EllisHobby/Capstone-Project-2022/README.md

# Ortho-matryx Capstone Project

# To install:

# > Open terminal

# > Move to ../Ortho-matryx directory

# > RUN: "sudo bash install.sh"

# > Device will restart and open game application
