EllisHobby/Capstone-Project-2022/gui-app/images/0.png

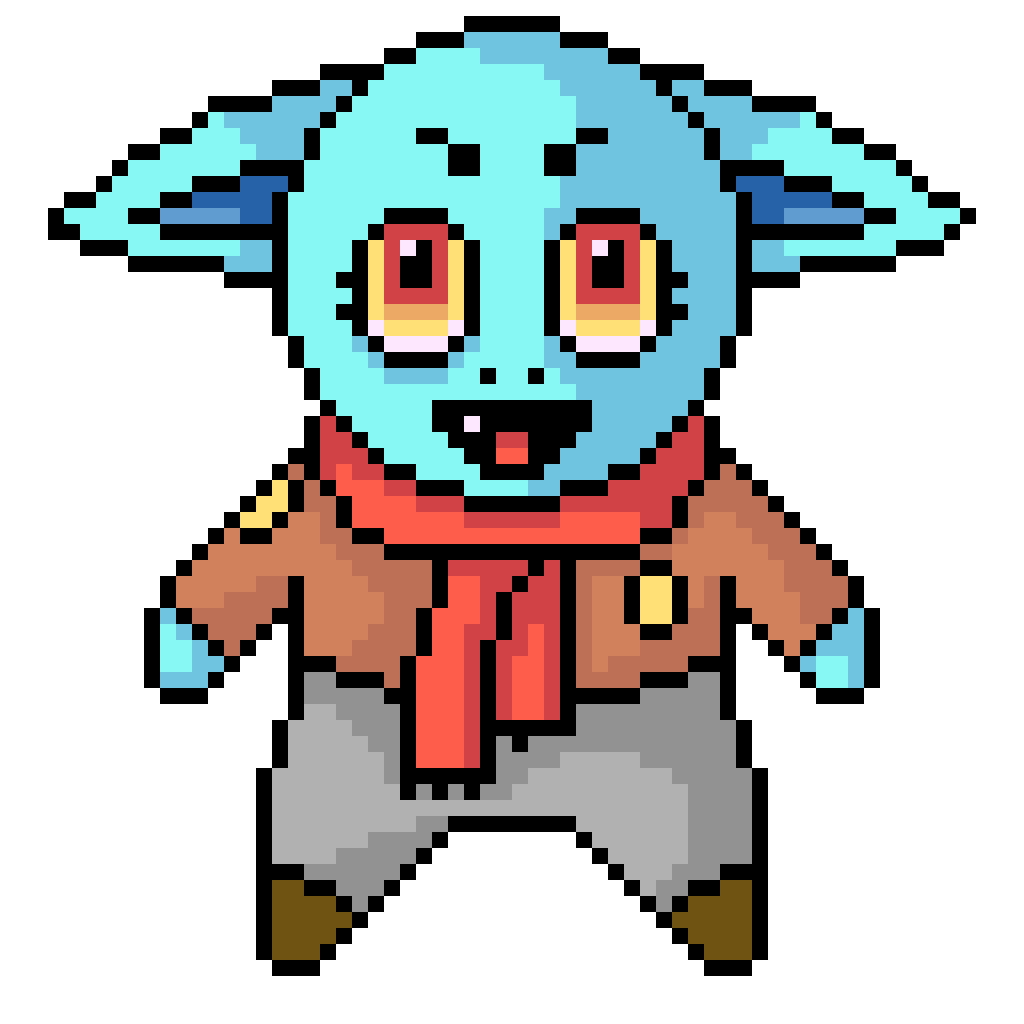
gui-app/images/0.png
