EllisHobby/Capstone-Project-2022/gui-app/images/1.png

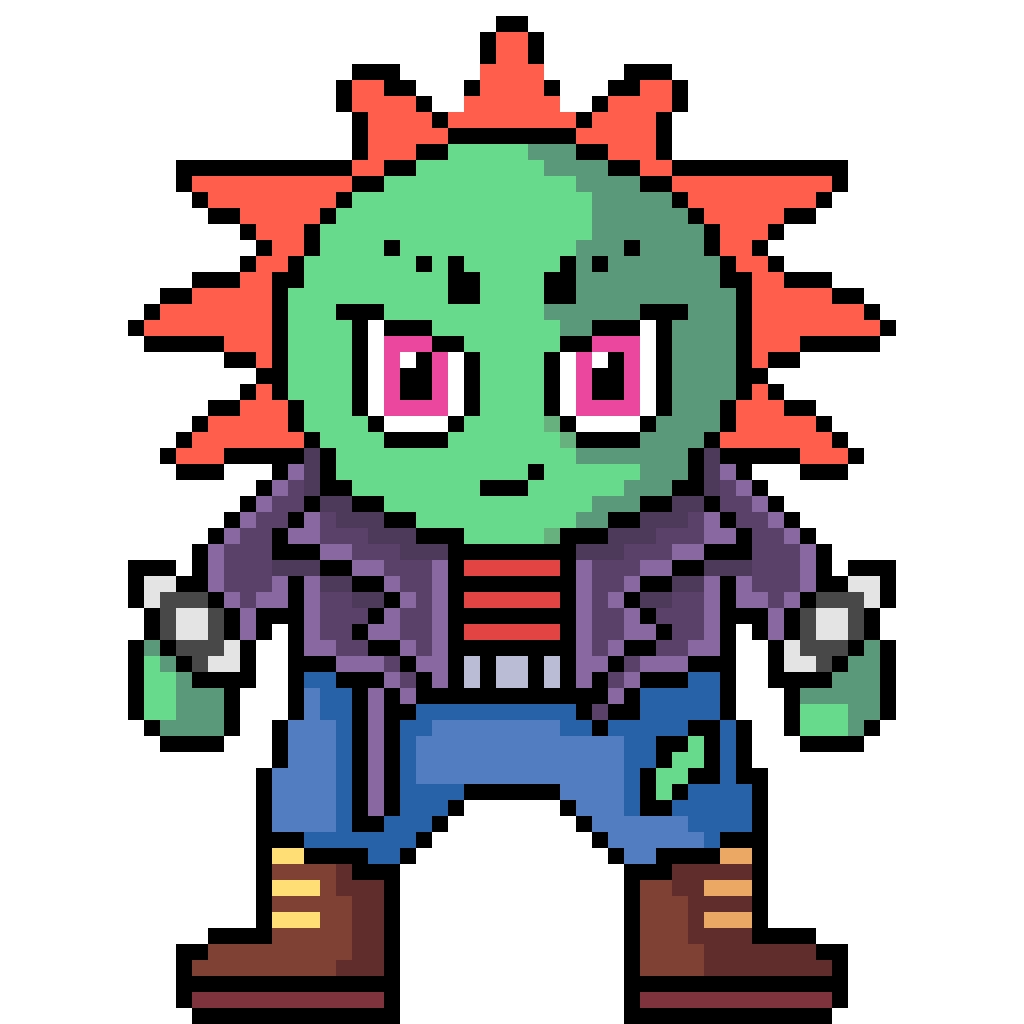
gui-app/images/1.png
