EllisHobby/Capstone-Project-2022/gui-app/images/2.png

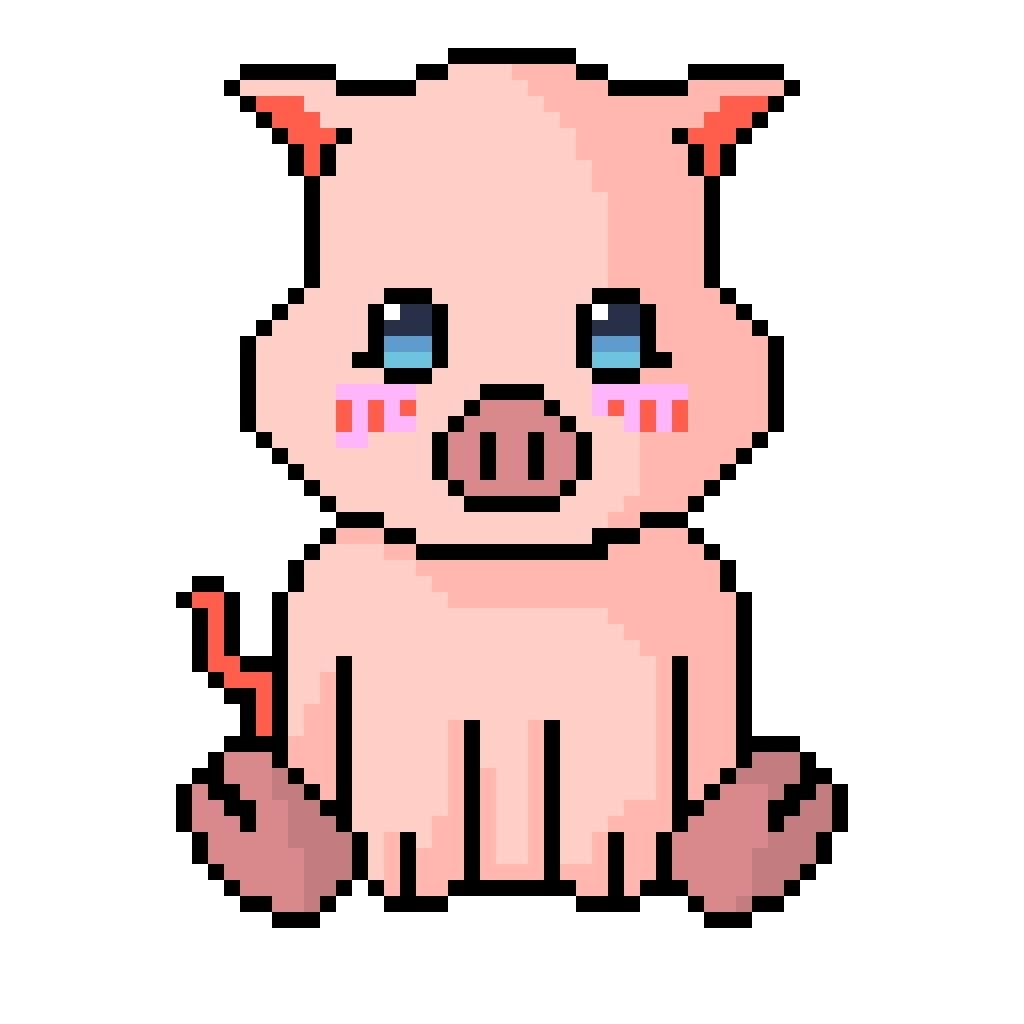
gui-app/images/2.png
