EllisHobby/Capstone-Project-2022/gui-app/images/3.png

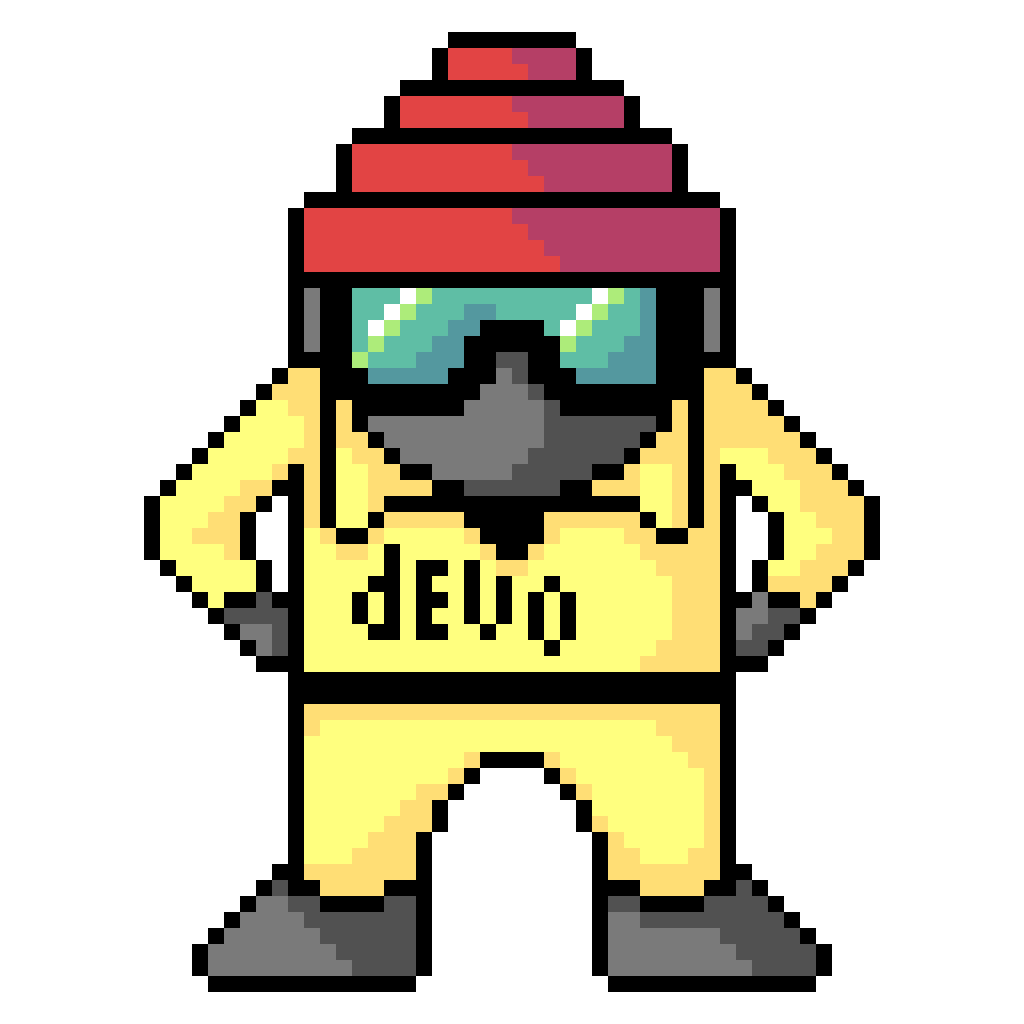
gui-app/images/3.png
