EllisHobby/Capstone-Project-2022/gui-app/images/4.png

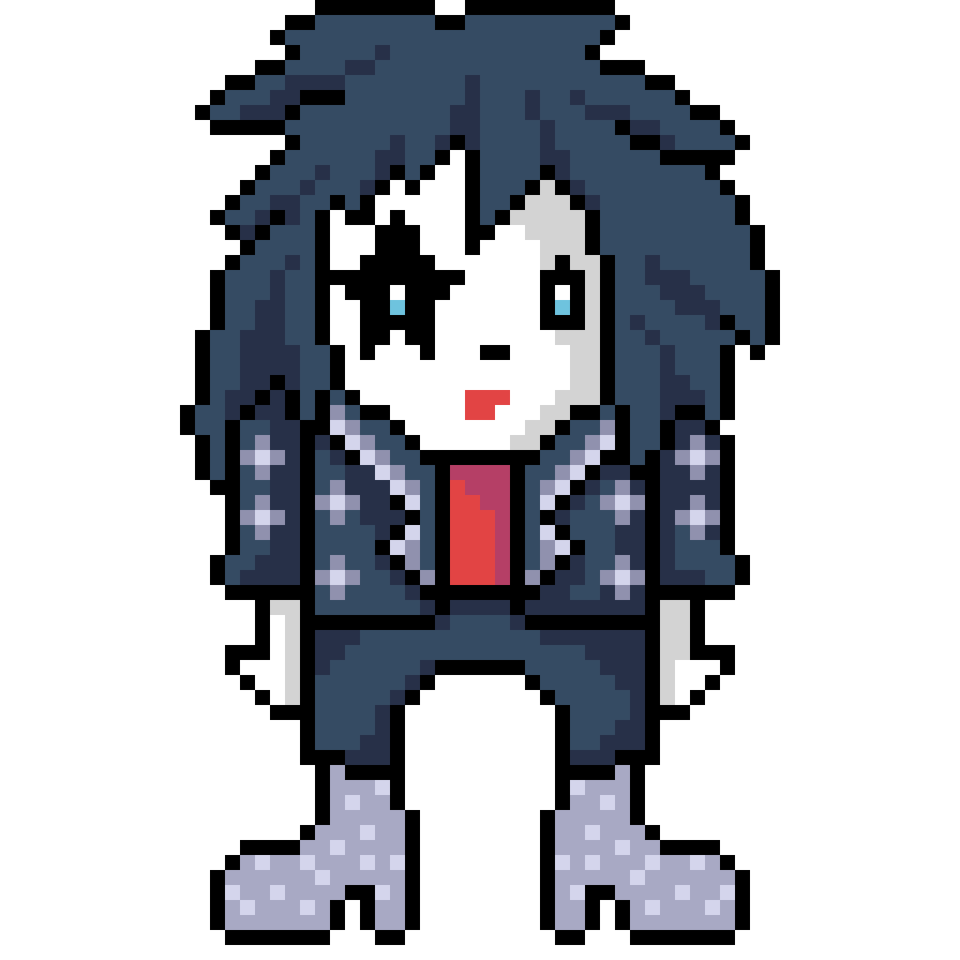
gui-app/images/4.png
