EllisHobby/Capstone-Project-2022/gui-app/images/5.png

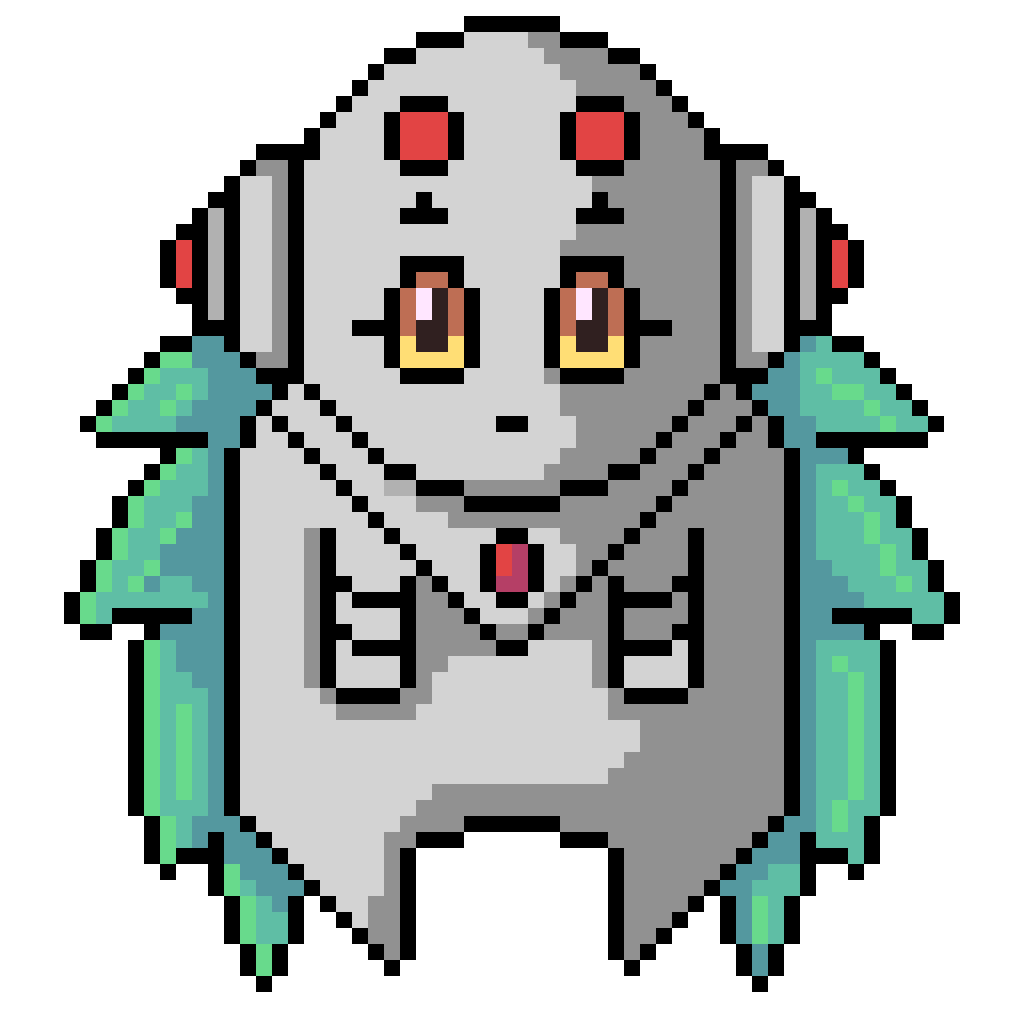
gui-app/images/5.png
