EllisHobby/Capstone-Project-2022/schematics-pcb/V6_Sheet1.png

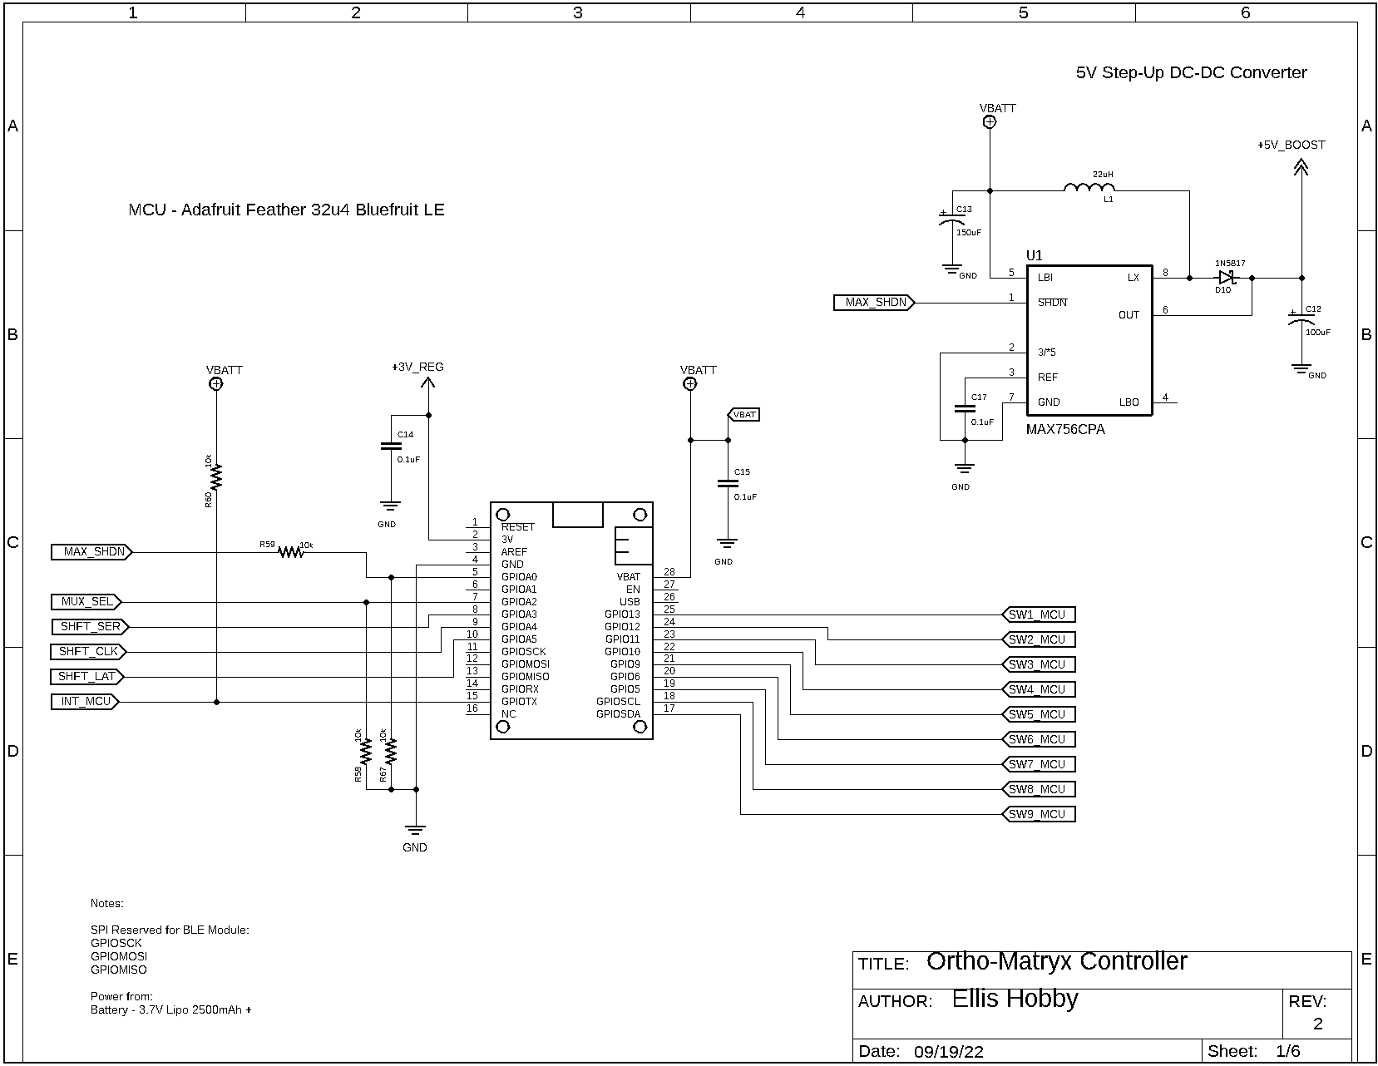
schematics-pcb/V6_Sheet1.png
