EllisHobby/Capstone-Project-2022/schematics-pcb/V6_Sheet6.png

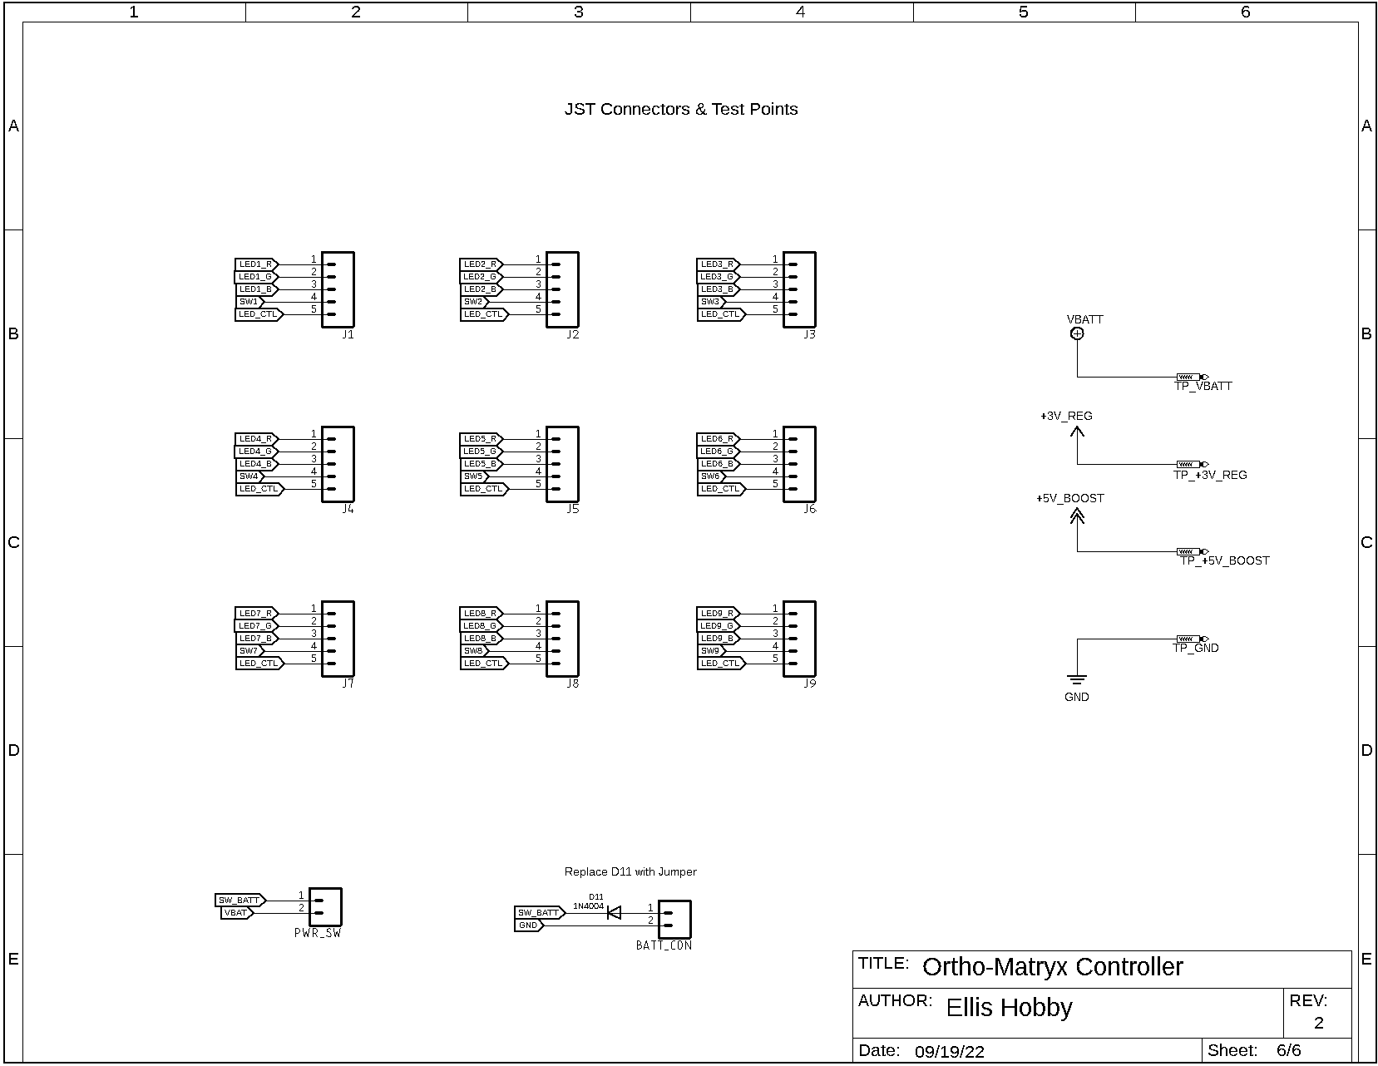
schematics-pcb/V6_Sheet6.png
