EllisHobby/Capstone-Project-2022/schematics-pcb/ControllerV6.brd

## EAGLE design schematics-pcb/ControllerV6.brd (2022-12-15)

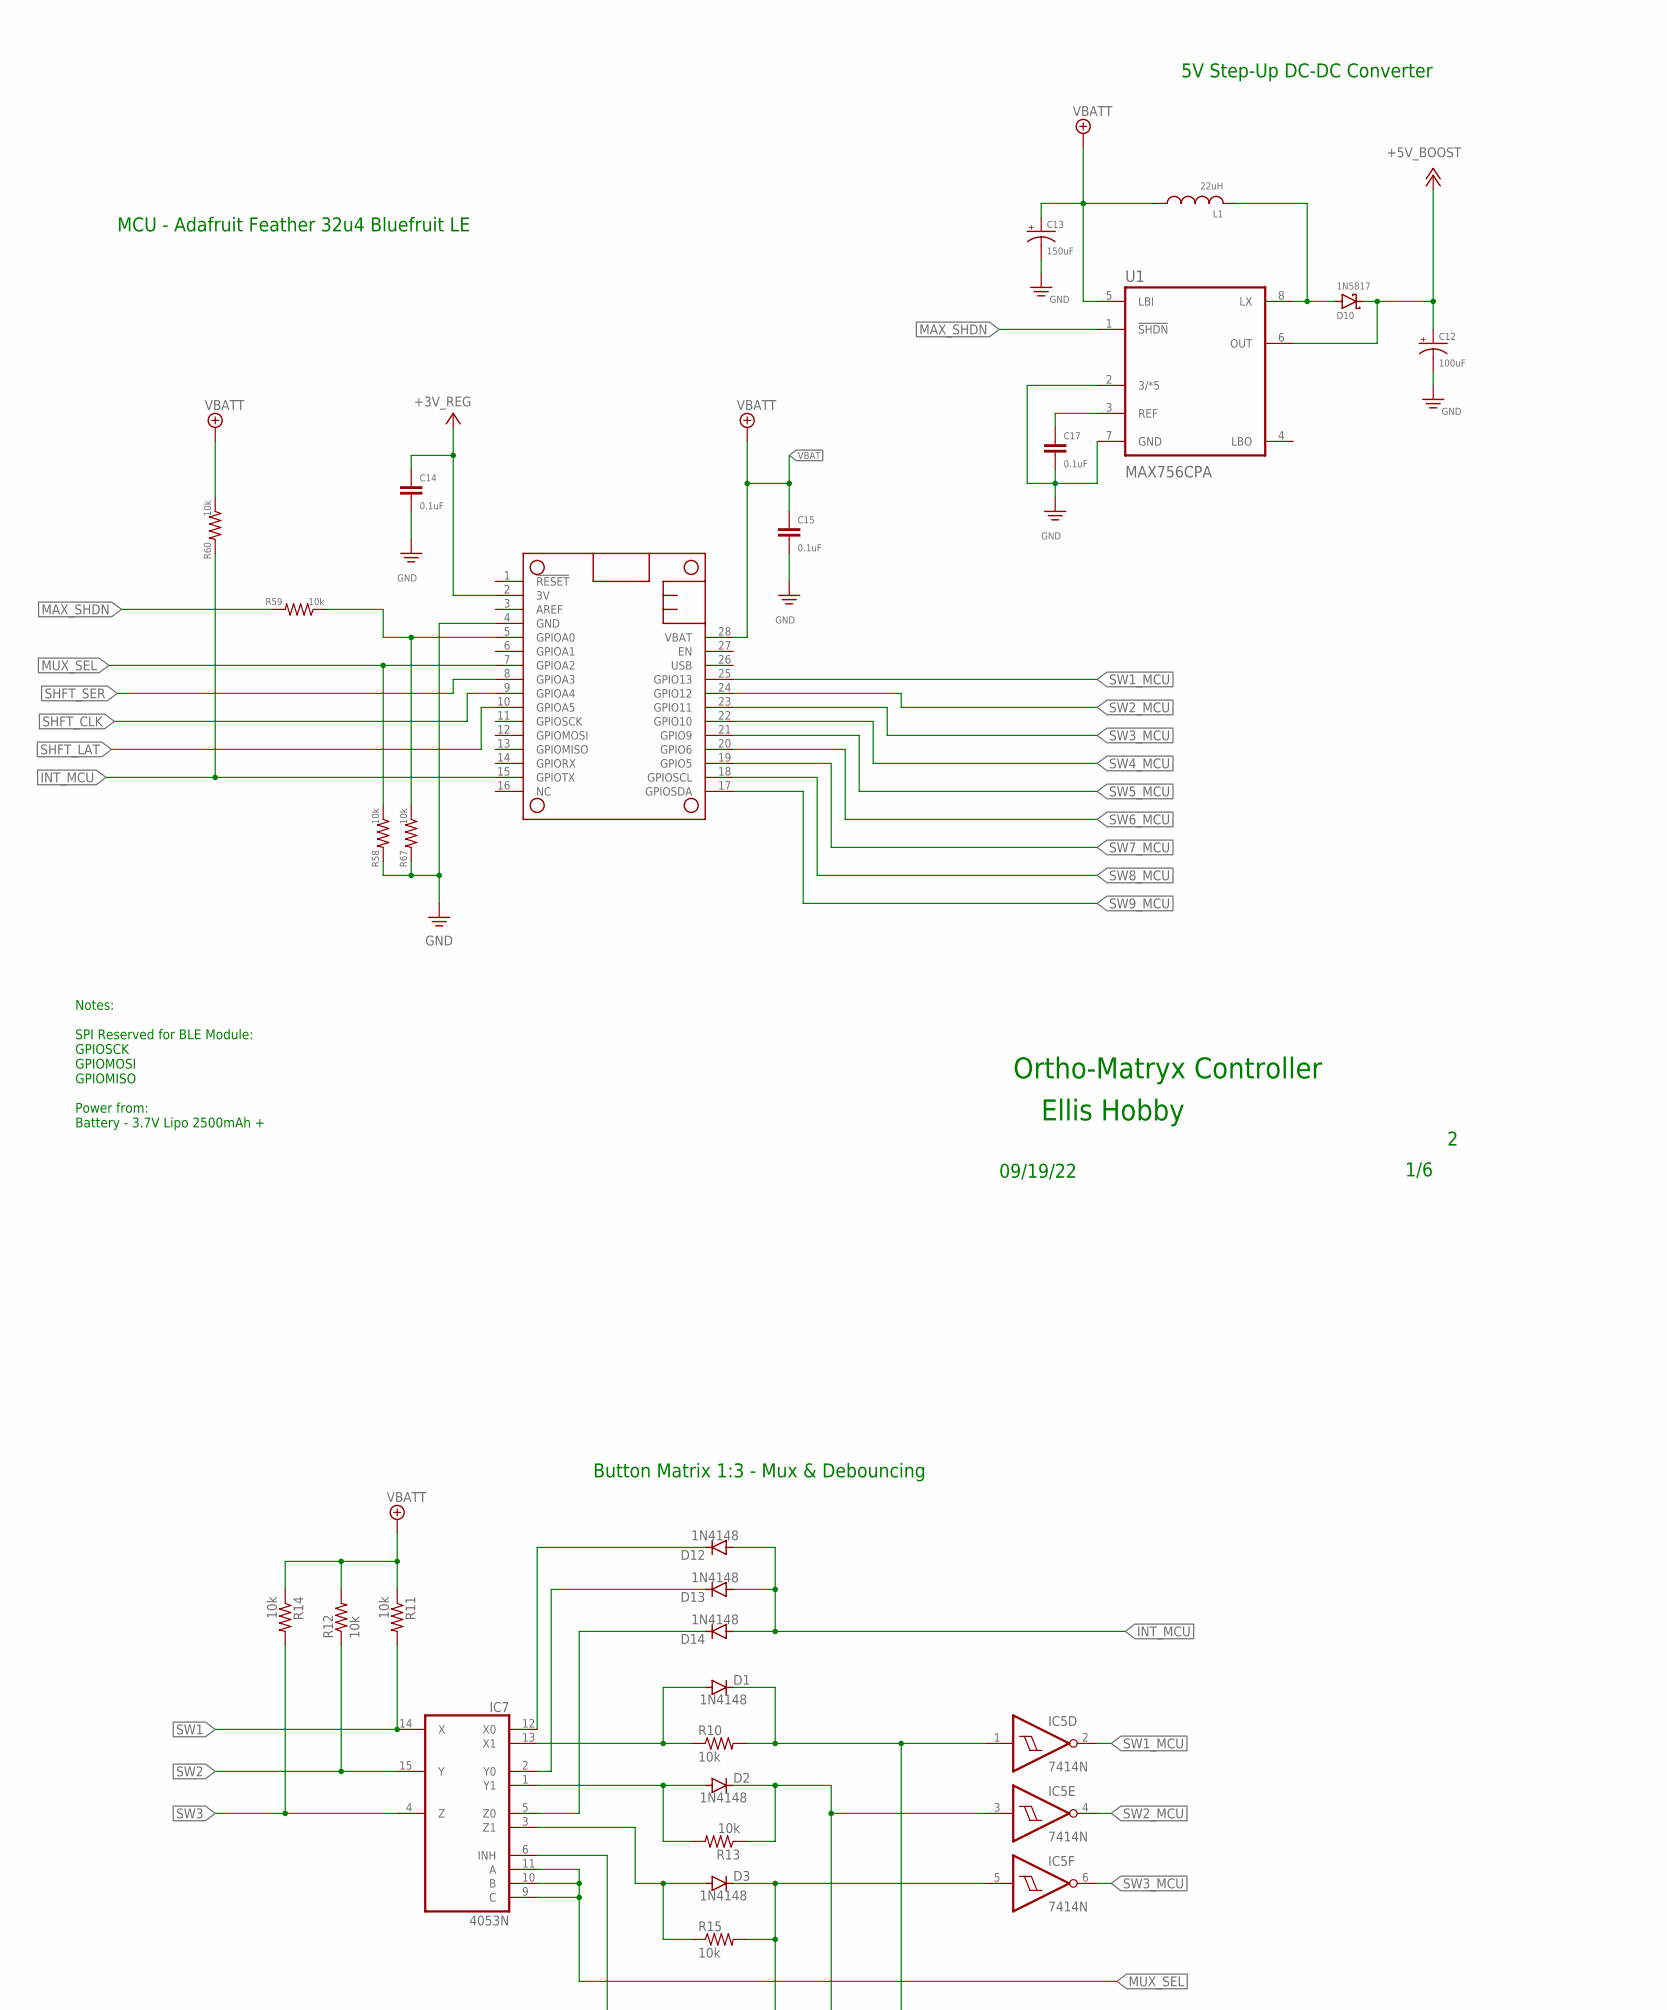
[picture p13: schematic ControllerV6.sch, sheet 1, part in row 1, column 1]

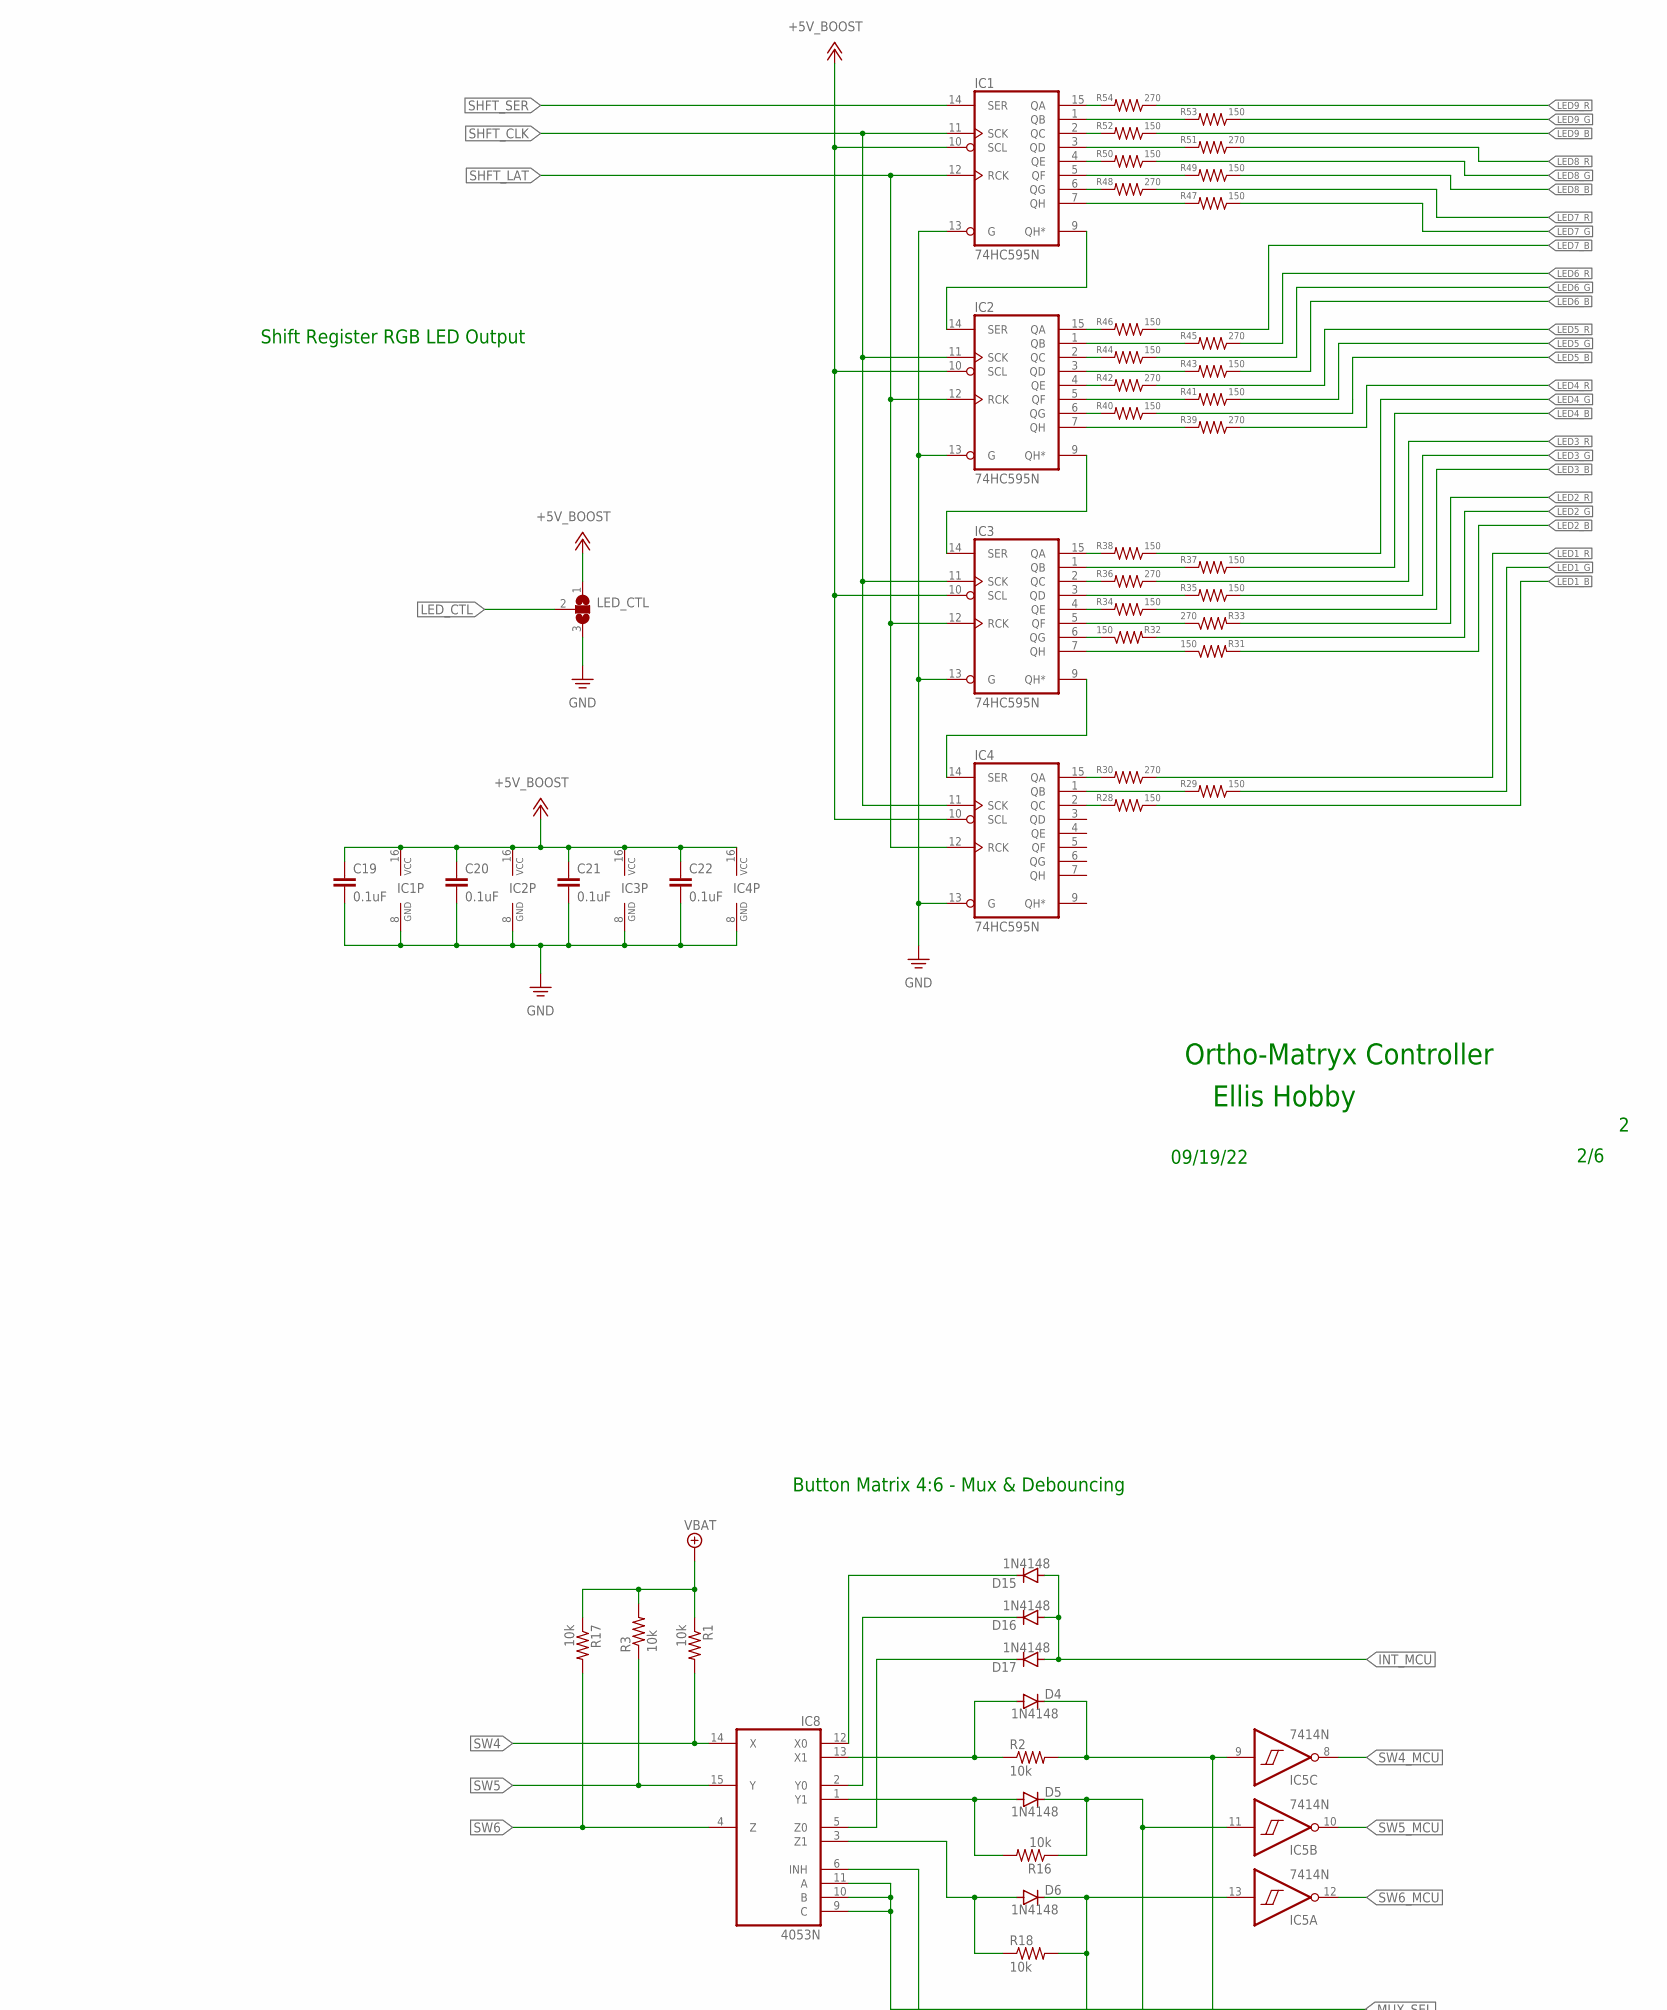
[picture p14: schematic ControllerV6.sch, sheet 1, part in row 1, column 2]

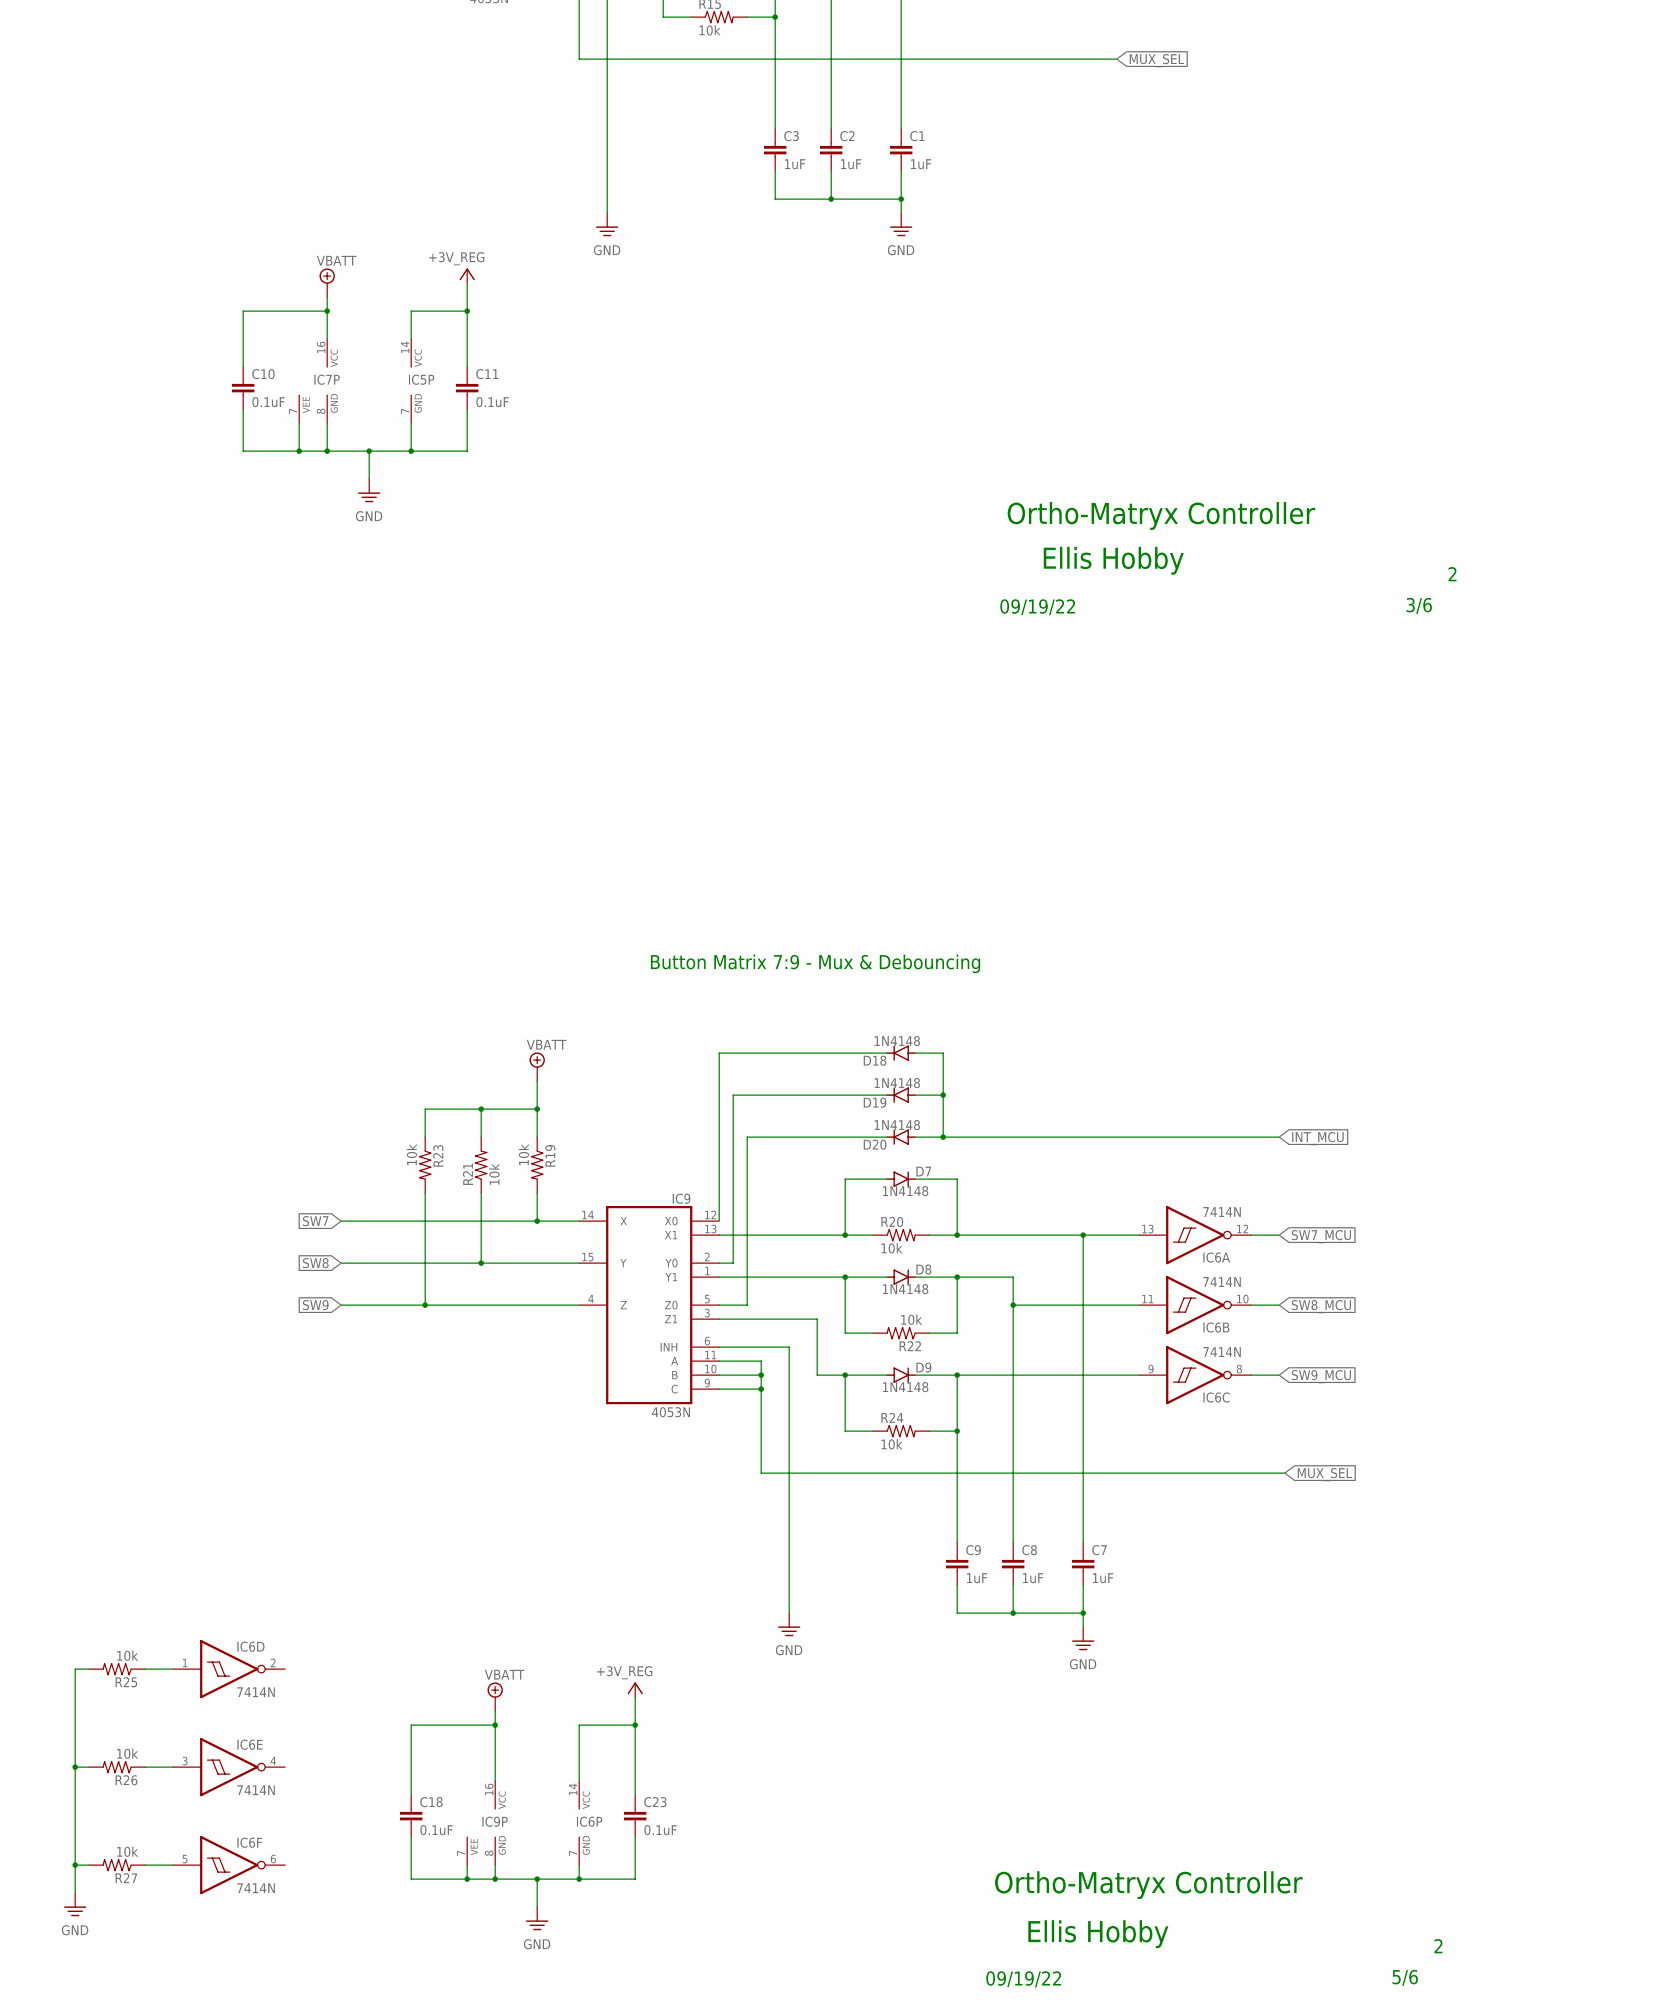
[picture p15: schematic ControllerV6.sch, sheet 1, part in row 2, column 1]

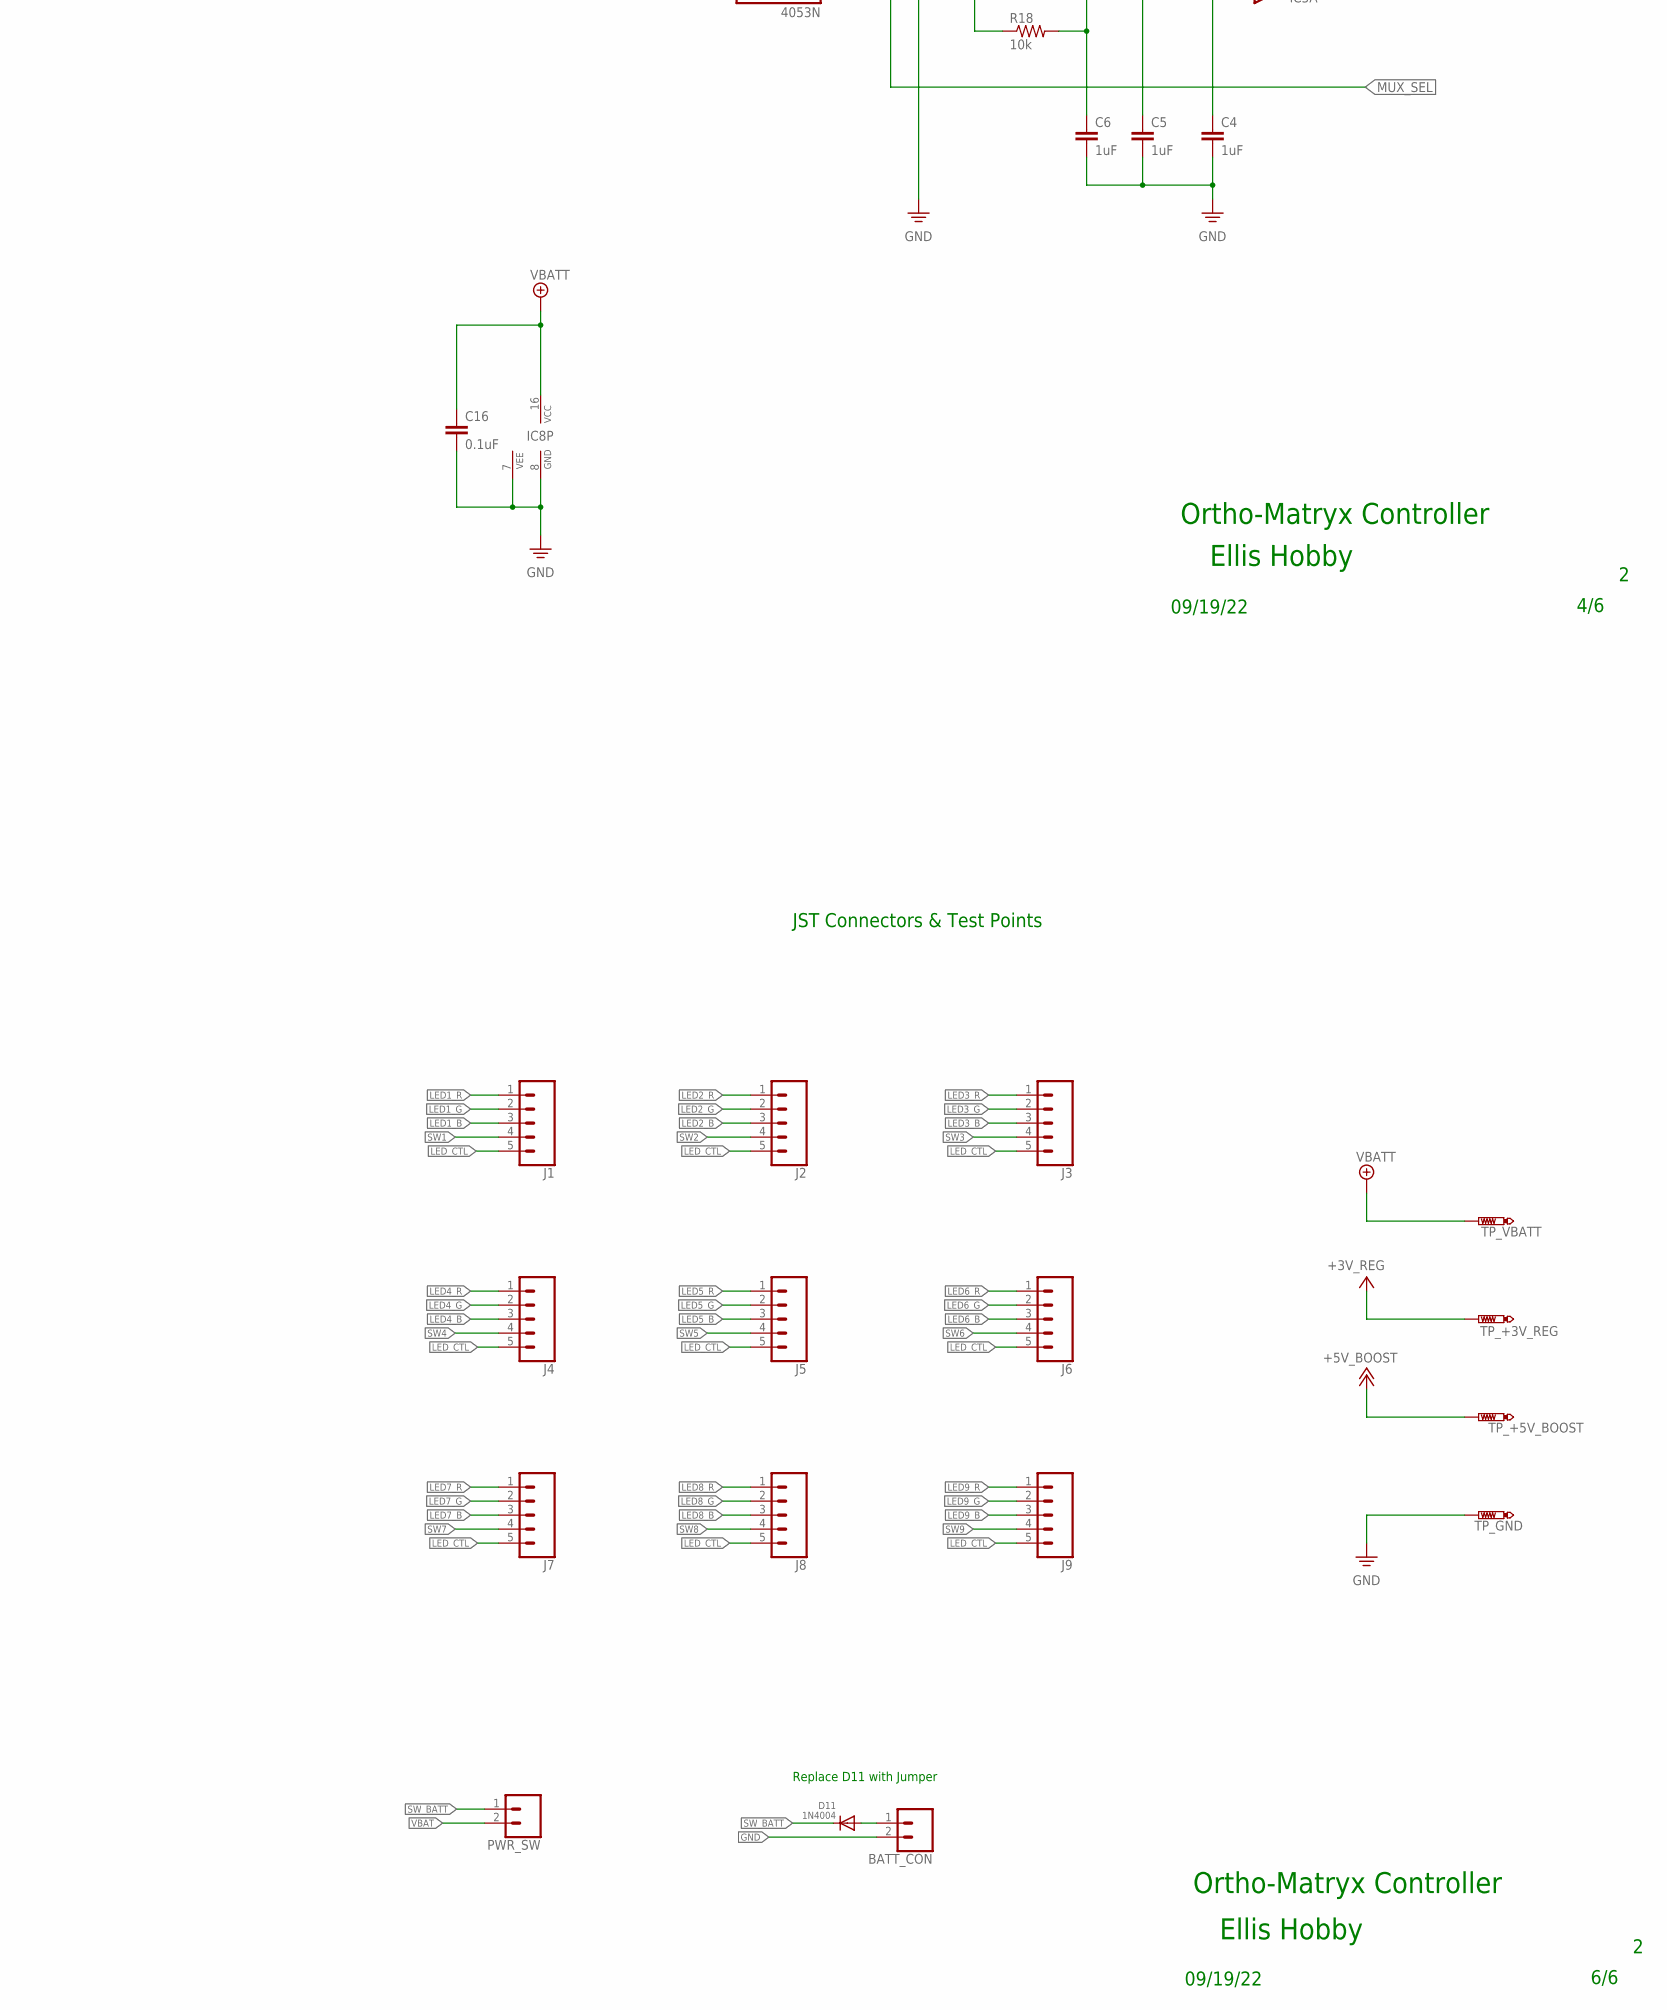
[picture p16: schematic ControllerV6.sch, sheet 1, part in row 2, column 2]

Parts:
BATT_CON: CONN_02POLAR; MOLEX-1X2
C1, C2, C3, C4, C5, C6, C7, C8, C9: 1uF; C025-025X050
C10, C11, C14, C15, C16, C17, C18, C19, C20, C21, C22, C23: 0.1uF; C025-025X050
C12: 100uF; E1,8-4
C13: 150uF; E1,8-4
D1, D2, D3, D4, D5, D6, D7, D8, D9, D12, D13, D14, D15, D16, D17, D18, D19, D20: 1N4148; DO35-7
D10: 1N5817; DO41-7.6
D11: 1N4004; DO41-10
IC1, IC2, IC3, IC4: 74HC595N; DIL16
IC5, IC6: 7414N; DIL14
IC7, IC8, IC9: 4053N; DIL16
J1, J2, J3, J4, J5, J6, J7, J8, J9: CONN_05JST-VERT; JST-5-PTH-VERT
L1: 22uH; 0204/5
LED_CTL: SJ2WW; SJ_2W
MS2: FEATHERWING
PWR_SW: CONN_02POLAR; MOLEX-1X2
R1, R2, R3, R10, R11, R12, R13, R14, R15, R16, R17, R18, R19, R20, R21, R22, R23, R24, R25, R26, R27, R58, R59, R60, R67: 10k; 0204/5
R28, R29, R31, R32, R34, R35, R37, R38, R40, R41, R43, R44, R46, R47, R49, R50, R52, R53: 150; 0204/5
R30, R33, R36, R39, R42, R45, R48, R51, R54: 270; 0204/5
TP_+3V_REG, TP_+5V_BOOST: PTR1PAD1-13Y; P1-13Y
TP_GND: PTR1PAD1-13Y; P1-13Y
TP_VBATT: PTR1PAD1-13Y; P1-13Y
U1: MAX756CPA; DIP794W47P254L991H457Q8

Connections:
+3V_REG: C11.1, C14.1, C23.1, IC5.14 (VCC), IC6.14 (VCC), MS2.2 (3V), TP_+3V_REG.TP
+5V_BOOST: C12.+, C19.1, C20.1, C21.1, C22.1, D10.C, IC1.10 (SCL), IC1.16 (VCC), IC2.10 (SCL), IC2.16 (VCC), IC3.10 (SCL), IC3.16 (VCC), IC4.10 (SCL), IC4.16 (VCC), LED_CTL.1, TP_+5V_BOOST.TP, U1.6 (OUT)
D1: C1.1, D1.C, IC5.1 (I), R10.2
D2: C2.1, D2.C, IC5.3 (I), R13.1
D3: C3.1, D3.C, IC5.5 (I), R15.2
D4: C4.1, D4.C, IC5.9 (I), R2.2
D5: C5.1, D5.C, IC5.11 (I), R16.1
D6: C6.1, D6.C, IC5.13 (I), R18.2
D7: C7.1, D7.C, IC6.13 (I), R20.2
D8: C8.1, D8.C, IC6.11 (I), R22.1
D9: C9.1, D9.C, IC6.9 (I), R24.2
GND: BATT_CON.2, C1.2, C2.2, C3.2, C4.2, C5.2, C6.2, C7.2, C8.2, C9.2, C10.2, C11.2, C12.-, C13.-, C14.2, C15.2, C16.2, C17.2, C18.2, C19.2, C20.2, C21.2, C22.2, C23.2, IC1.8 (GND), IC1.13 (G), IC2.8 (GND), IC2.13 (G), IC3.8 (GND), IC3.13 (G), IC4.8 (GND), IC4.13 (G), IC5.7 (GND), IC6.7 (GND), IC7.6 (INH), IC7.7 (VEE), IC7.8 (GND), IC8.6 (INH), IC8.7 (VEE), IC8.8 (GND), IC9.6 (INH), IC9.7 (VEE), IC9.8 (GND), LED_CTL.3, MS2.4 (GND), R25.2, R26.2, R27.2, R58.2, R67.2, TP_GND.TP, U1.2 (3/*5), U1.7 (GND)
INT_MCU: D12.A, D13.A, D14.A, D15.A, D16.A, D17.A, D18.A, D19.A, D20.A, MS2.15 (GPIOTX), R60.2
LED1_B: J1.3, R28.1
LED1_G: J1.2, R29.1
LED1_R: J1.1, R30.1
LED2_B: J2.3, R31.2
LED2_G: J2.2, R32.2
LED2_R: J2.1, R33.2
LED3_B: J3.3, R34.1
LED3_G: J3.2, R35.1
LED3_R: J3.1, R36.1
LED4_B: J4.3, R37.1
LED4_G: J4.2, R38.1
LED4_R: J4.1, R39.1
LED5_B: J5.3, R40.1
LED5_G: J5.2, R41.1
LED5_R: J5.1, R42.1
LED6_B: J6.3, R43.1
LED6_G: J6.2, R44.1
LED6_R: J6.1, R45.1
LED7_B: J7.3, R46.1
LED7_G: J7.2, R47.1
LED7_R: J7.1, R48.1
LED8_B: J8.3, R49.1
LED8_G: J8.2, R50.1
LED8_R: J8.1, R51.1
LED9_B: J9.3, R52.1
LED9_G: J9.2, R53.1
LED9_R: J9.1, R54.1
LED_CTL: J1.5, J2.5, J3.5, J4.5, J5.5, J6.5, J7.5, J8.5, J9.5, LED_CTL.2
MAX_SHDN: R59.2, U1.1 (!SHDN)
MUX_SEL: IC7.9 (C), IC7.10 (B), IC7.11 (A), IC8.9 (C), IC8.10 (B), IC8.11 (A), IC9.9 (C), IC9.10 (B), IC9.11 (A), MS2.7 (GPIOA2), R58.1
unnamed: IC4.15 (QA), R30.2
unnamed: IC4.1 (QB), R29.2
unnamed: BATT_CON.1, D11.A
unnamed: D1.A, IC7.13 (X1), R10.1
unnamed: C17.1, U1.3 (REF)
unnamed: D13.C, IC7.2 (Y0)
unnamed: D14.C, IC7.5 (Z0)
unnamed: D2.A, IC7.1 (Y1), R13.2
unnamed: D16.C, IC8.2 (Y0)
unnamed: D12.C, IC7.12 (X0)
unnamed: D3.A, IC7.3 (Z1), R15.1
unnamed: D17.C, IC8.5 (Z0)
unnamed: D4.A, IC8.13 (X1), R2.1
unnamed: IC1.9 (QH*), IC2.14 (SER)
unnamed: IC2.9 (QH*), IC3.14 (SER)
unnamed: D5.A, IC8.1 (Y1), R16.2
unnamed: D15.C, IC8.12 (X0)
unnamed: D6.A, IC8.3 (Z1), R18.1
unnamed: D7.A, IC9.13 (X1), R20.1
unnamed: D8.A, IC9.1 (Y1), R22.2
unnamed: D9.A, IC9.3 (Z1), R24.1
unnamed: D18.C, IC9.12 (X0)
unnamed: D19.C, IC9.2 (Y0)
unnamed: D20.C, IC9.5 (Z0)
unnamed: IC4.2 (QC), R28.2
unnamed: IC1.15 (QA), R54.2
unnamed: IC3.9 (QH*), IC4.14 (SER)
unnamed: IC1.1 (QB), R53.2
unnamed: IC1.2 (QC), R52.2
unnamed: IC3.5 (QF), R33.1
unnamed: IC3.6 (QG), R32.1
unnamed: IC3.7 (QH), R31.1
unnamed: MS2.5 (GPIOA0), R59.1, R67.1
unnamed: IC1.3 (QD), R51.2
unnamed: IC1.4 (QE), R50.2
unnamed: IC1.5 (QF), R49.2
unnamed: IC3.4 (QE), R34.2
unnamed: IC3.2 (QC), R36.2
unnamed: IC3.3 (QD), R35.2
unnamed: IC1.6 (QG), R48.2
unnamed: IC1.7 (QH), R47.2
unnamed: IC2.15 (QA), R46.2
unnamed: IC2.1 (QB), R45.2
unnamed: IC2.2 (QC), R44.2
unnamed: IC2.3 (QD), R43.2
unnamed: IC2.4 (QE), R42.2
unnamed: IC2.6 (QG), R40.2
unnamed: IC2.7 (QH), R39.2
unnamed: IC3.15 (QA), R38.2
unnamed: IC3.1 (QB), R37.2
unnamed: IC2.5 (QF), R41.2
unnamed: IC6.1 (I), R25.1
unnamed: IC6.3 (I), R26.1
unnamed: IC6.5 (I), R27.1
unnamed: D10.A, L1.2, U1.8 (LX)
SHFT_CLK: IC1.11 (SCK), IC2.11 (SCK), IC3.11 (SCK), IC4.11 (SCK), MS2.9 (GPIOA4)
SHFT_LAT: IC1.12 (RCK), IC2.12 (RCK), IC3.12 (RCK), IC4.12 (RCK), MS2.10 (GPIOA5)
SHFT_SER: IC1.14 (SER), MS2.8 (GPIOA3)
SW1: IC7.14 (X), J1.4, R11.2
SW1_MCU: IC5.2 (O), MS2.25 (GPIO13)
SW2: IC7.15 (Y), J2.4, R12.1
SW2_MCU: IC5.4 (O), MS2.24 (GPIO12)
SW3: IC7.4 (Z), J3.4, R14.2
SW3_MCU: IC5.6 (O), MS2.23 (GPIO11)
SW4: IC8.14 (X), J4.4, R1.2
SW4_MCU: IC5.8 (O), MS2.22 (GPIO10)
SW5: IC8.15 (Y), J5.4, R3.1
SW5_MCU: IC5.10 (O), MS2.21 (GPIO9)
SW6: IC8.4 (Z), J6.4, R17.2
SW6_MCU: IC5.12 (O), MS2.20 (GPIO6)
SW7: IC9.14 (X), J7.4, R19.2
SW7_MCU: IC6.12 (O), MS2.19 (GPIO5)
SW8: IC9.15 (Y), J8.4, R21.1
SW8_MCU: IC6.10 (O), MS2.18 (GPIOSCL)
SW9: IC9.4 (Z), J9.4, R23.2
SW9_MCU: IC6.8 (O), MS2.17 (GPIOSDA)
SW_BATT: D11.C, PWR_SW.1
VBAT: C10.1, C13.+, C15.1, C16.1, C18.1, IC7.16 (VCC), IC8.16 (VCC), IC9.16 (VCC), L1.1, MS2.28 (VBAT), PWR_SW.2, R1.1, R3.2, R11.1, R12.2, R14.1, R17.1, R19.1, R21.2, R23.1, R60.1, TP_VBATT.TP, U1.5 (LBI)

Notes on the sheet:
Shift Register RGB LED Output
MCU - Adafruit Feather 32u4 Bluefruit LE
5V Step-Up DC-DC Converter
Notes: SPI Reserved for BLE Module: GPIOSCK GPIOMOSI GPIOMISO Power from: Battery - 3.7V Lipo 2500mAh +
Ortho-Matryx Controller
Ellis Hobby
09/19/22
1/6
2/6
3/6
6/6
4/6
5/6
Button Matrix 1:3 - Mux & Debouncing
Button Matrix 4:6 - Mux & Debouncing
Button Matrix 7:9 - Mux & Debouncing
JST Connectors & Test Points
Replace D11 with Jumper

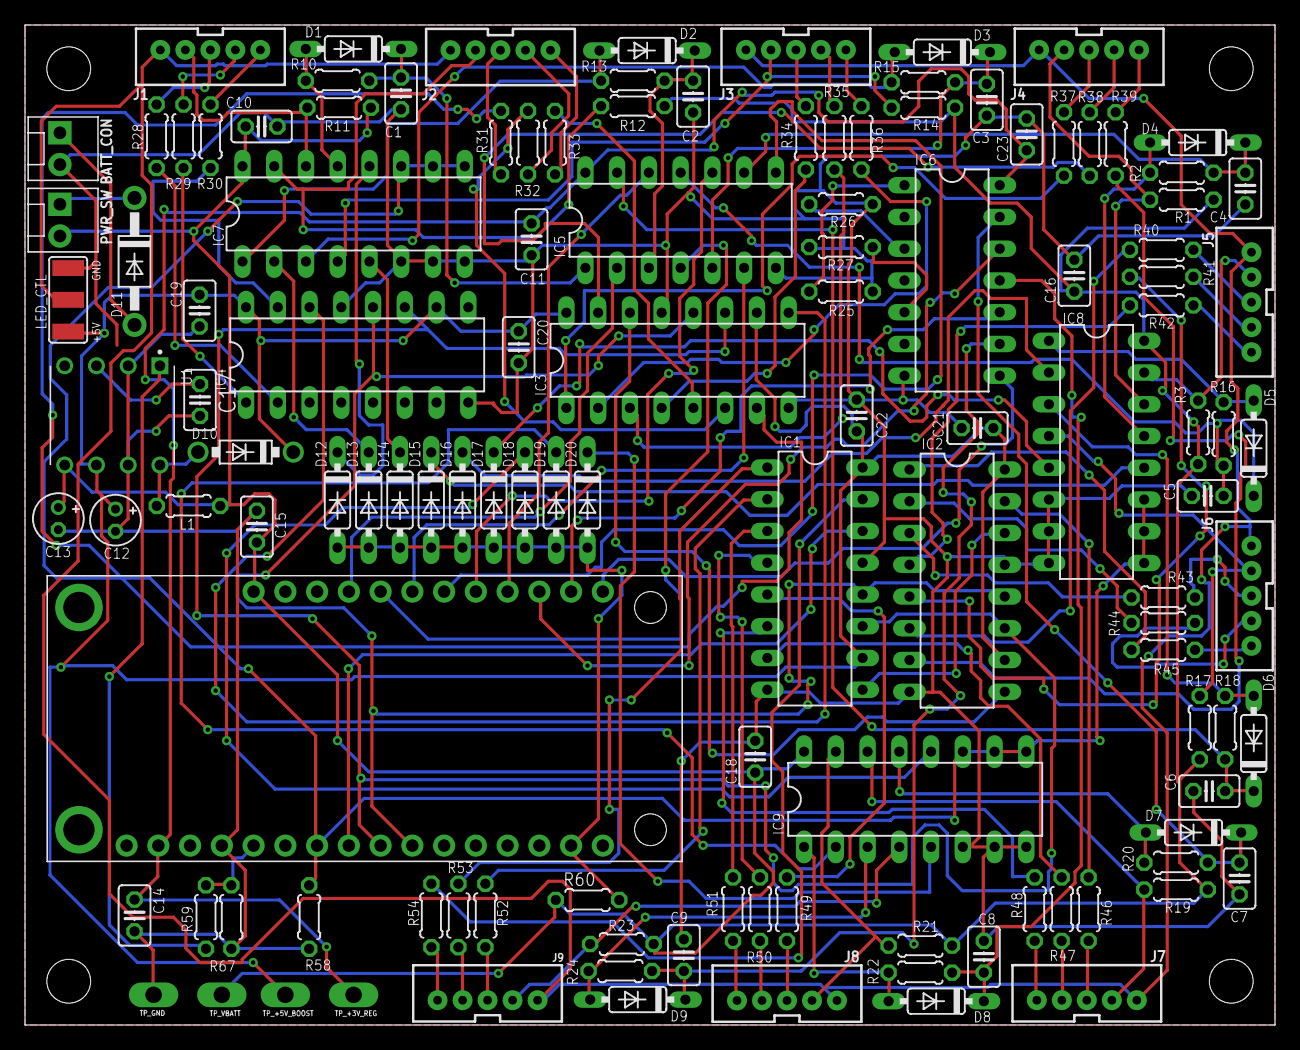
[picture p17: board ControllerV6.brd from above]

Board: 2 copper layers, 100.0 x 80.0 mm, 123 parts (0 on the bottom side), 121 nets.
